ahmedsaed/Specular/optics/README.md

# Optics subsystem

Mounts for the telescope's optical elements.

## Parts

| Part | What it is | Status |
|---|---|---|
| [`secondary-holder/`](secondary-holder/) | 45° mechanical mount for the elliptical secondary (diagonal) mirror — replaces the builder's failed glue job. | v1, in design |

*Future candidates: primary mirror cell, focuser-side field stop / baffles.*
