ahmedsaed/Specular/(list of files, cad)

Other CAD files:
focuser/quick-release/qr_focuser_base.scad
qr_bracket.scad
optics/secondary-holder/secondary_holder_hooks_v1.scad
