ahmedsaed/Specular/(commit log)

2026-06-29 Add initial files for telescope focuser project including .gitignore, README, and SCAD models
    [curved_nut.scad, focuser_base.scad, qr_bracket.scad]
2026-06-29 Add initial SCAD files for bayonet focuser assembly and components
    [assembly.scad, qr_bracket.scad, qr_focuser_base.scad]
2026-06-30 Enhance QR bracket and focuser base with new pin modes and screw mechanism details
    [qr_bracket.scad, qr_focuser_base.scad]
2026-07-02 Add secondary mirror holder v1 (mirror mount only)
    Parametric OpenSCAD holder that seats a 25mm elliptical secondary
    (FJ-25) at 45 deg, replacing the builder's failed glue job. Flat pad
    + shallow retaining lip, mirror held by 3 silicone dabs keyed to 3
    pockets. Lip is asserted shorter than the mirror so it never shadows
    the reflective face.
    v1 scope is the mirror-holding part only; the back is a flat
    placeholder face for a future spider-hub attach part. Mirror thickness
    and major axis are parametric (measure on arrival, re-export).
    part = "holder" | "mirror" | "coupon". README documents params, print
    notes, and a no-scope bench test, following house conventions.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
    [secondary_holder.scad]
2026-07-04 Restructure into subsystems; redesign secondary holder; add QR cover + eyepiece adapter
    - Reorganize the flat repo into focuser/, optics/, and eyepiece/ subsystems, each
    with per-part READMEs, plus a top-level overview + parts index.
    - Keep the tube-side base folder as "base (original)".
    - Secondary holder: redesign as a snap-arm edge clamp for the 45-degree oblique-prism
    mirror. The mirror + hooks are modelled vertically then sheared as one, so the hooks
    lean to follow the glass (outward = slide-in end, inward = clip end); hooks cluster
    +/-arm_off from the long axis; pads/flat seat; plate sized to the mirror with only
    small hook tabs (clear light path); central M3 cap-head mount h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
    [assembly.scad, curved_nut.scad, focuser_base.scad, microscope_1in_adapter.scad, qr_bracket.scad, qr_cover.scad, qr_focuser_base.scad, secondary_holder.scad]
2026-07-05 Refine eyepiece clamp design: update captive nut placement and adjust assembly instructions for clarity
    [microscope_1in_adapter.scad]
2026-07-05 Enhance microscope adapter clamp design: add clamp depth adjustment and modify nut pocket for improved assembly
    [microscope_1in_adapter.scad]
2026-07-05 QR bayonet: fillet lug roots to stop knock-off; relieve bracket lip to clear
    [qr_bracket.scad, qr_cover.scad, qr_focuser_base.scad]
2026-07-05 Update seat mode in secondary mirror holder to use full backing for improved stability
    [secondary_holder.scad]
2026-07-10 Add convex flare to flange for improved printability and support
    [microscope_1in_adapter.scad]
2026-07-12 Adjust undercut height and flare for improved fit and printability
    [microscope_1in_adapter.scad]
2026-07-20 Increase printed-fit clearance for filter thread to improve compatibility
    [microscope_1in_adapter.scad]
2026-07-20 Update mirror thickness in secondary mirror holder for accuracy
    [secondary_holder.scad]
2026-07-21 Refactor secondary mirror holder and mount
    - Updated README to reflect the new versioning and improvements of the secondary mirror holder.
    - Added `secondary_holder_hooks_v1.scad` for the snap-arm clamp design, emphasizing its limitations and the introduction of a new design.
    - Introduced `secondary_mount.scad` for the v2 bonded pocket and 3-screw sprung tilt stage, detailing its functionality and design considerations.
    - Created `secondary_mount_push.scad` for the v2-PUSH variant, outlining the differences in the tilt stage and the central tension mechanism.
    [secondary_holder_hooks_v1.scad, secondary_mount.scad, secondary_mount_push.scad]
2026-07-21 Refactor spring mechanism in secondary mount for improved preload and fit
    [secondary_mount.scad, secondary_mount_push.scad]
2026-07-22 Update secondary mount configuration for improved nut integration and detent features
    [secondary_mount_push.scad]
2026-07-22 Refactor captive nut design in quick-release components for improved engagement and clearance
    [qr_bracket.scad, qr_focuser_base.scad]
2026-07-22 adjust mount params
    [secondary_mount_push.scad]
2026-07-23 Update README and secondary mount files for clarity and improvements
    [secondary_mount.scad, secondary_mount_push.scad]
